moyashi170607/UIAP-Devices/app/README.md

# About / 概要

A repository that aggregates applications for UIAP devices.
By aggregating applications as a pair of software and hardware under an Open-Source and Copyleft license, it improves convenience for device users.

UIAPデバイスのアプリケーションを集約するリポジトリです。
アプリケーションをソフトウェアとハードウェアをセットにしてオープンソース・コピーレフトで集約することで、デバイスユーザの利便性を向上します。

概要図

**UIAP never deny copyright.**
Intellectual property added to this repository only becomes open source/copyleft.
List copyrighted information in the [Just Links](#just-links--リンク集) section.
There are no restrictions on proprietary or commercial use when listing.

**UIAPはコピーライトを否定しているわけではありません。**
このリポジトリの中に追加した知的財産がオープンソース・コピーレフトになるだけです。
コピーライトな情報は[リンク集](#just-links--リンク集)へ記載してください。
記載にプロプライエタリ・商用利用などの制約はありません。

# How to Add / 追加方法

Use the PR template to add to this repository. See [split-keyboard](split-keyboard) for an example of an edited template.

このリポジトリへ追加するPRテンプレートを使用します。テンプレートを編集した例は[split-keyboard](split-keyboard)を参照してください。

```bash
git clone https://github.com/YuukiUmeta-UIAP/UIAP-Devices.git
cd UIAP-Devices/app
cp -r template your-app-title
# Edit and commit then PR!
```

# Just Links / リンク集

A list of links to applications that are independent (unrelated) to this repository.
This list is incomplete.
**Follow copyright and license in the information at the link.**
Any media format is fine, as long as it is accessible via URL, such as Twitter, personal blogs, or sharing services.
You can also link to your own applications.
Add and share them. PRs for any corrections or additions.

このリポジトリから独立している(無関係な)アプリケーションへのリンクリストです。
リストは不完全です。
**著作権やライセンスはリンク先の情報に従って下さい。**
URLアクセスできるものならツイッターや個人ブログ、シェアサービスなど、メディア形式は問いません。
自分のアプリケーションをリンクしてもOKです。
ぜひ追加してシェアしてください。
修正や追加はPRをお願いします。

## Reproducible / 再現可能

It contains all or part of the information necessary to reproduce the application.

アプリケーションを再現するために必要な情報が断片的もしくは完全に含まれているもの。

- [“UIAPduino” の検索結果 | 創造技術実習 | とにかく、ものづくり！](https://robo164.com/?s=UIAPduino)
- [inajob/CH32V003-GameConsole: Handheld RISC-V Mini Game Console with OLED Display](https://github.com/inajob/CH32V003-GameConsole)
- [UIAPduino Sample Programs](https://github.com/pokibon3/UIAPduino)
  - [お安くなったUIAPduinoを使って、簡易スペアナとモールス信号のデコーダーを作ってみました。](https://x.com/pokibon/status/1973356650405961889)
- [CH32V003でブロック崩しをつくった記録 ― ChatGPTがククトニアンと一緒にゲームを開発した7つのステップ ―](https://kuktonian.blogspot.com/2025/10/20251011.html)
- [ADCTOUCH + USB-MIDI example for UIAPDuino](https://github.com/hsgw/midi_sampler)
  - Recommended to play with [MIDI Sampler](https://github.com/hsgw/midi_sampler)
- MAX31855でこて先温度計
  - [MAX31855でこて先温度計（設計編） - 3ギガ10センチ](https://norichiwo.hatenablog.com/entry/2025/11/13/231647)
  - [MAX31855でこて先温度計（製作編） - 3ギガ10センチ](https://norichiwo.hatenablog.com/entry/2025/11/15/120858)
- [moyashi170607/Misskey_Nostr_Notifier: UIAPduinoを用いたMisskey, Nostrの通知デバイス](https://github.com/moyashi170607/Misskey_Nostr_Notifier)
- [UIAP KEYER](https://www.gejigeji.com/?page_id=1045)
  - [UIAP Message Keyer (CH32V003) Ver1.2](https://github.com/pokibon3/uiap_message_keyer)
- [UIAPduino Pro Microを使った格安マクロパッドをつくってみた【書きかけ】｜まーびい](https://note.com/marby/n/na17e2f9e2e09)

## Crafts / 作品

Introduction of applications that are clearly working and unique.

動作することが明らか、かつ、ユニークなアプリケーションを紹介したもの。

- [I'm following the trend too: : r/cyberDeck](https://www.reddit.com/r/cyberDeck/comments/1jb4ria/im_following_the_trend_too/)
- [Just a "party trick" | UIAPduino Pro Micro CH32V003 V1.4 - YouTube](https://www.youtube.com/watch?v=YItTtpDSDTk)
- [Gemini CLI(無料枠)だけで携帯ゲーム向けの2048が作れた！ - YouTube](https://www.youtube.com/watch?v=ztnDVnJdpo0)

## Tips / ヒント

Information that is beneficial when using the devices.
It may need to be categorized or organized.

デバイスを利用するさいに有用な情報が含まれるもの。
分類や整理が必要かも知れません。

- [UIAPduino Pro Micro CH32V003 - fab-wiki](https://scrapbox.io/fab-wiki/UIAPduino_Pro_Micro_CH32V003)
- [Noxim / uiapduino-rust · GitLab](https://owo.codes/noxim/uiapduino-rust)
- [UIAPduinoをMacで使う。With WCH-LINKE #Arduino - Qiita](https://qiita.com/NWLab/items/82bcfd8d3300df087445)
- [2025W07](https://blog.ikejima.org/weekly/2025/02/17/2025w07.html)
- [創り手と直接話せて楽しいNT加賀2025、UIAPduinoで三三七拍子](https://fukuno.jig.jp/4596)
- [UIAPduinoで遊ぶ　#1｜じゃけさん](https://note.com/jake_nagoya_mh/n/n2b382907497f)
- [つくろがや3でゲットしたおみやげを全部使う！ | ProtoPedia](https://protopedia.net/prototype/6719)
- [UIAPduino Pro Micro CH32V003 V1.4 と OLED SSD1306 – ぱらめでぃうす](https://parame.mwj.jp/wp/archives/1290)
- [VXQの無線運用、製作: UIAPduino Pro Micro CH32V003 V1.4を動作させてみました](https://coselec1500.blogspot.com/2025/12/uiapduino-pro-micro-ch32v003-v14.html)

## Media / メディア

Information that provides an objective view of the applicability of the devices.
Objectivity must be carefully discussed.
It may not be appropriate to include it in this repository.

デバイスの応用性についての客観的な見解が得られる情報が含まれるもの。
客観性を慎重に議論する必要があります。
本来はこのリポジトリに記載するべきではないかも知れません。

- [UIAPduino Pro Micro CH32V003 «  Adafruit Industries – Makers, hackers, artists, designers and engineers!](https://blog.adafruit.com/2024/09/11/uiapduino-pro-micro-ch32v003/)
- [Arduino開発ボード「UIAPduino Pro Micro CH32V003 V1.4」発売 | fabcross](https://web.archive.org/web/20250323012648/https://fabcross.jp/news/2024/20240919_UIAPduino.html)
- [安いCH32V003開発ボードUIAPduino – inajobのいろいろレビュー](https://inajob.github.io/iroiro-review/post/%E5%AE%89%E3%81%84ch32v003%E9%96%8B%E7%99%BA%E3%83%9C%E3%83%BC%E3%83%89uiapduino/)
- [290円マイコン、はじめました。－ UIAPduinoで楽しむ電子工作の第一歩 －](https://techbookfest.org/product/sDGEXY3qqMqBZvXUbQGVTV)
  - Buy now: [Melonbooks](https://www.melonbooks.co.jp/detail/detail.php?product_id=3346303) / [BOOTH](https://booth.pm/ja/items/7707666) / [架空ストア](https://store.retro-biz.com/i24085.html) / [Amazon](https://www.amazon.co.jp/dp/B0GJDMKQBL)
- [290円のCH32V003開発ボード「UIAPduino Pro Micro」発売、教育向けに充実ドキュメント - FabScene（ファブシーン）](https://fabscene.com/new/news/uiapduino-pro-micro-ch32v003-v14-290yen/)
