moyashi170607/UIAP-Devices/app/low-cost_diy_keyboard/.src/img/PXL_20251125_064817963.jpg

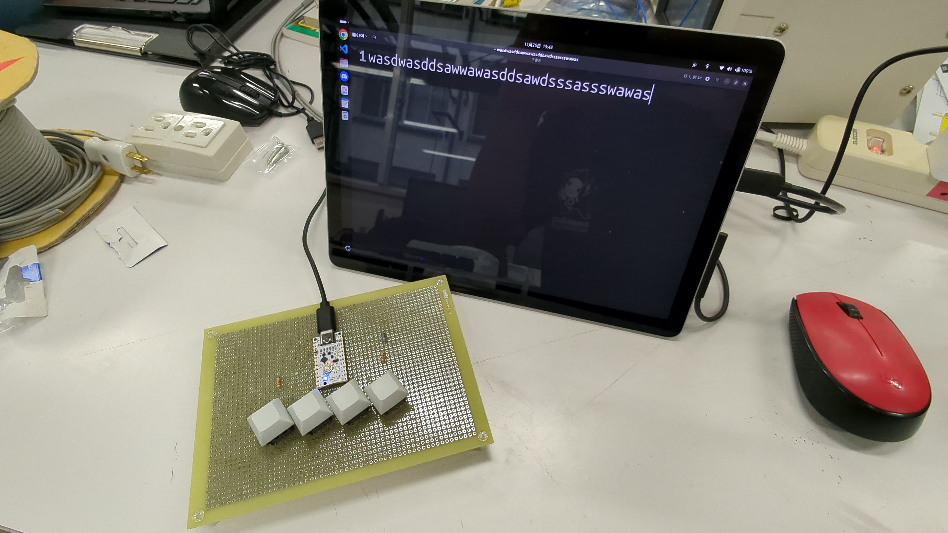
app/low-cost_diy_keyboard/.src/img/PXL_20251125_064817963.jpg
