moyashi170607/UIAP-Devices/app/low-cost_diy_keyboard/.src/img/PXL_20251205_060952252.jpg

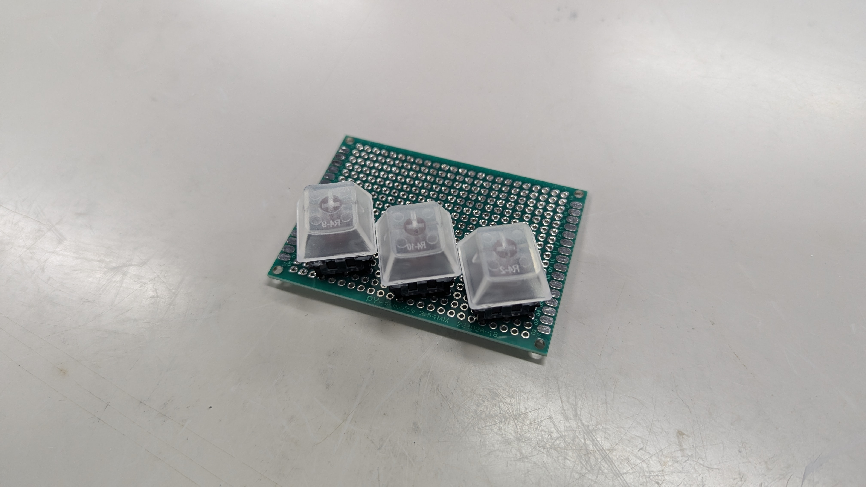
app/low-cost_diy_keyboard/.src/img/PXL_20251205_060952252.jpg
