moyashi170607/UIAP-Devices/(list of files, drawings)

Other design files:
app/low-cost_diy_keyboard/.src/doc/low-cost_diy_keyboard_20251205.fzz
