moyashi170607/UIAP-Devices/(commit log)

2025-12-05 Add instruction for making $5 DIY keyboard
    [low-cost_diy_keyboard_20251205.fzz]
2026-02-10 Add drill bit diameters on low-cost_diy_keyboard/README.md
